bharathsharma95/Transparent_Keyboard/README.md

# Transparent_Keyboard
This is a project based o Embedded C which implements the functionality of a keyboard with IR Emitters and receivers which help achieve the transparent functionality
